JTing86/Medistation_FYDP2022/PCBs/dispenser/components/footprints/SSOP5/SSOP5_ROM.step

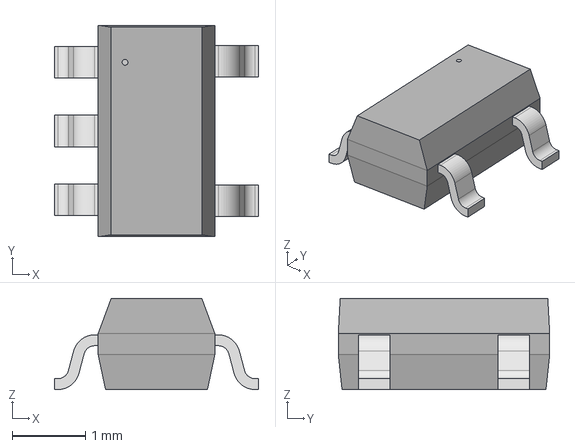
[picture p1: CAD file, 2022-03-11]
PCBs/dispenser/components/footprints/SSOP5/SSOP5_ROM.step
2.79 x 2.90 x 1.25 mm
