JTing86/Medistation_FYDP2022/PCBs/dispenser/components/footprints/10118194-0001LF/10118194-0001LF.step

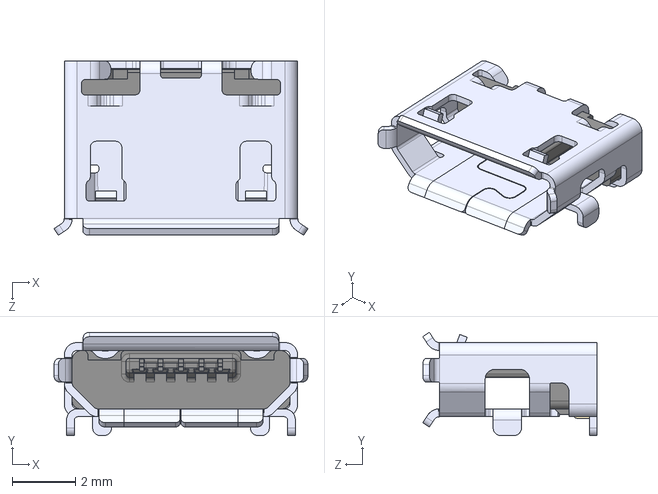
[picture p2: CAD file, 2022-03-11]
PCBs/dispenser/components/footprints/10118194-0001LF/10118194-0001LF.step
8.05 x 3.27 x 5.53 mm
