JTing86/Medistation_FYDP2022/PCBs/dispenser/dispenser.kicad_pcb

## KiCad design PCBs/dispenser/dispenser.kicad_pcb (2022-03-11)

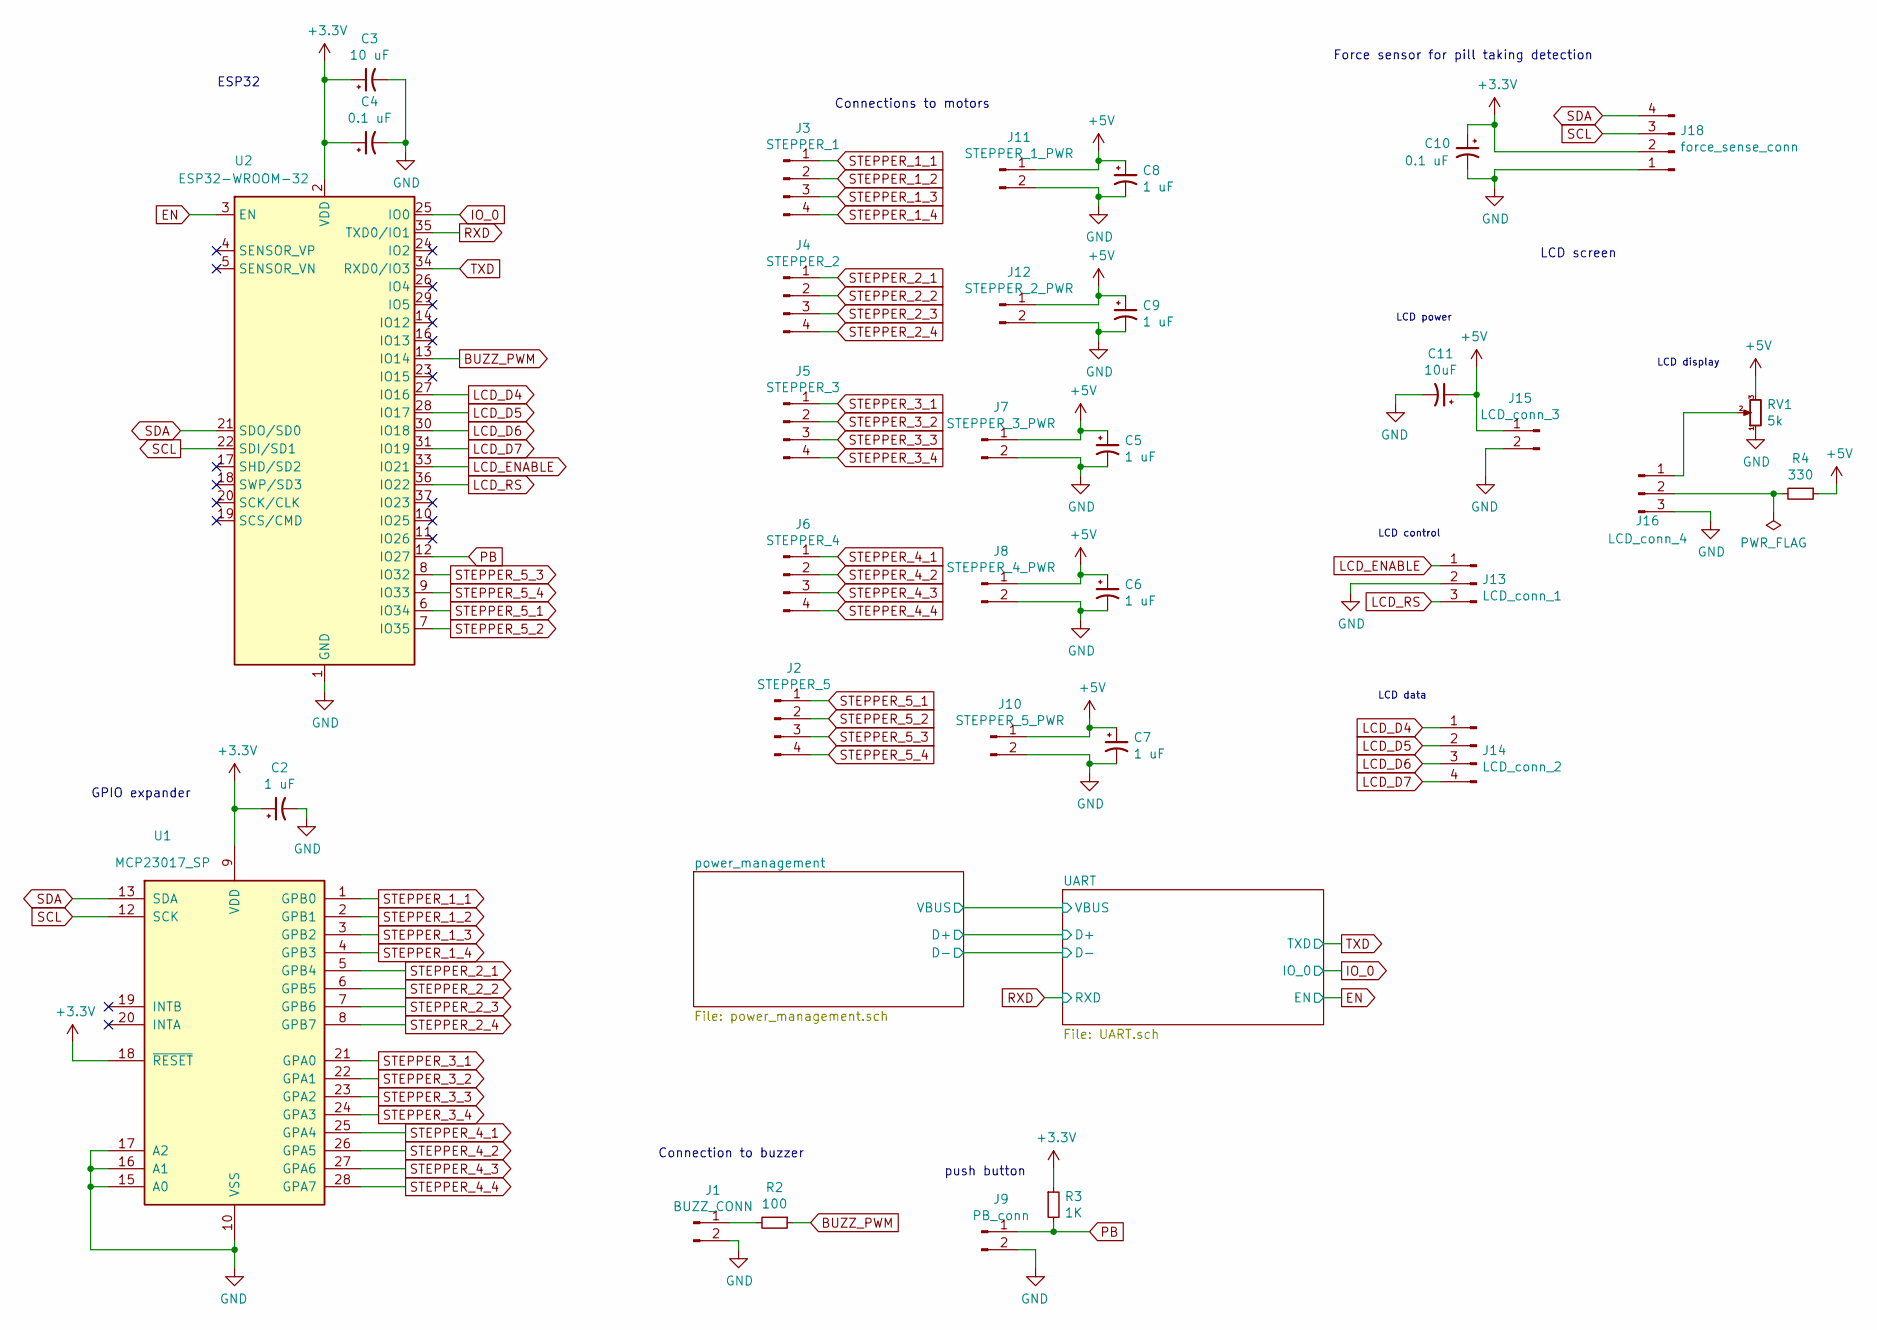
[picture p3: schematic dispenser.sch]

Parts:
C2, C5, C6, C7, C8, C9: 1 uF; C_0603_1608Metric_Pad1.08x0.95mm_HandSolder
C3: 10 uF; C_0603_1608Metric_Pad1.08x0.95mm_HandSolder
C4, C10: 0.1 uF; C_0603_1608Metric_Pad1.08x0.95mm_HandSolder
C11: 10uF; C_0603_1608Metric_Pad1.08x0.95mm_HandSolder
J1: BUZZ_CONN; PinHeader_1x02_P2.54mm_Vertical
J2: STEPPER_5; PinHeader_1x04_P2.54mm_Vertical
J3: STEPPER_1; PinHeader_1x04_P2.54mm_Vertical
J4: STEPPER_2; PinHeader_1x04_P2.54mm_Vertical
J5: STEPPER_3; PinHeader_1x04_P2.54mm_Vertical
J6: STEPPER_4; PinHeader_1x04_P2.54mm_Vertical
J7: STEPPER_3_PWR; B2B-ZRLFSN
J8: STEPPER_4_PWR; B2B-ZRLFSN
J9: PB_conn; PinHeader_1x02_P2.54mm_Vertical
J10: STEPPER_5_PWR; B2B-ZRLFSN
J11: STEPPER_1_PWR; B2B-ZRLFSN
J12: STEPPER_2_PWR; B2B-ZRLFSN
J13: LCD_conn_1; PinHeader_1x03_P2.54mm_Vertical
J14: LCD_conn_2; PinHeader_1x04_P2.54mm_Vertical
J15: LCD_conn_3; PinHeader_1x02_P2.54mm_Vertical
J16: LCD_conn_4; PinHeader_1x03_P2.54mm_Vertical
J18: force_sense_conn; PinHeader_1x04_P2.54mm_Vertical
R2: 100; R_0603_1608Metric_Pad0.98x0.95mm_HandSolder
R3: 1K; R_0603_1608Metric_Pad0.98x0.95mm_HandSolder
R4: 330; R_0603_1608Metric_Pad0.98x0.95mm_HandSolder
RV1: 5k; CT-6EP501
U1: MCP23017_SP; DIP-28_W7.62mm
U2: ESP32-WROOM-32

Connections:
+3V3: C2.1, C3.1, C4.1, C10.1, J18.2, R3.1, U1.9 (VDD), U1.18 (~RESET~), U2.2 (VDD); also elsewhere on the board
+5V: C5.1, C6.1, C7.1, C8.1, C9.1, C11.1, J7.1, J8.1, J10.1, J11.1, J12.1, J15.1, R4.1, RV1.3; also elsewhere on the board
BUZZ_PWM: R2.1, U2.13 (IO14)
EN: U2.3 (EN); also elsewhere on the board
GND: C2.2, C3.2, C4.2, C5.2, C6.2, C7.2, C8.2, C9.2, C10.2, C11.2, J1.2, J7.2, J8.2, J9.2, J10.2, J11.2, J12.2, J13.2, J15.2, J16.3, J18.1, RV1.1, U1.10 (VSS), U1.15 (A0), U1.16 (A1), U1.17 (A2), U2.1 (GND), U2.15 (GND), U2.38 (GND), U2.39 (GND); also elsewhere on the board
IO_0: U2.25 (IO0); also elsewhere on the board
LCD_D4: J14.1, U2.27 (IO16)
LCD_D5: J14.2, U2.28 (IO17)
LCD_D6: J14.3, U2.30 (IO18)
LCD_D7: J14.4, U2.31 (IO19)
LCD_ENABLE: J13.1, U2.33 (IO21)
LCD_RS: J13.3, U2.36 (IO22)
unnamed: J1.1, R2.2
unnamed: J16.1, RV1.2
unnamed: J16.2, R4.2
PB: J9.1, R3.2, U2.12 (IO27)
RXD: U2.35 (TXD0/IO1); also elsewhere on the board
SCL: J18.3, U1.12 (SCK), U2.22 (SDI/SD1)
SDA: J18.4, U1.13 (SDA), U2.21 (SDO/SD0)
STEPPER_1_1: J3.1, U1.1 (GPB0)
STEPPER_1_2: J3.2, U1.2 (GPB1)
STEPPER_1_3: J3.3, U1.3 (GPB2)
STEPPER_1_4: J3.4, U1.4 (GPB3)
STEPPER_2_1: J4.1, U1.5 (GPB4)
STEPPER_2_2: J4.2, U1.6 (GPB5)
STEPPER_2_3: J4.3, U1.7 (GPB6)
STEPPER_2_4: J4.4, U1.8 (GPB7)
STEPPER_3_1: J5.1, U1.21 (GPA0)
STEPPER_3_2: J5.2, U1.22 (GPA1)
STEPPER_3_3: J5.3, U1.23 (GPA2)
STEPPER_3_4: J5.4, U1.24 (GPA3)
STEPPER_4_1: J6.1, U1.25 (GPA4)
STEPPER_4_2: J6.2, U1.26 (GPA5)
STEPPER_4_3: J6.3, U1.27 (GPA6)
STEPPER_4_4: J6.4, U1.28 (GPA7)
STEPPER_5_1: J2.1, U2.6 (IO34)
STEPPER_5_2: J2.2, U2.7 (IO35)
STEPPER_5_3: J2.3, U2.8 (IO32)
STEPPER_5_4: J2.4, U2.9 (IO33)
TXD: U2.34 (RXD0/IO3); also elsewhere on the board

Notes on the sheet:
Force sensor for pill taking detection
push button
LCD screen
Connection to buzzer
LCD power
LCD control
LCD data
LCD display
ESP32
GPIO expander
Connections to motors

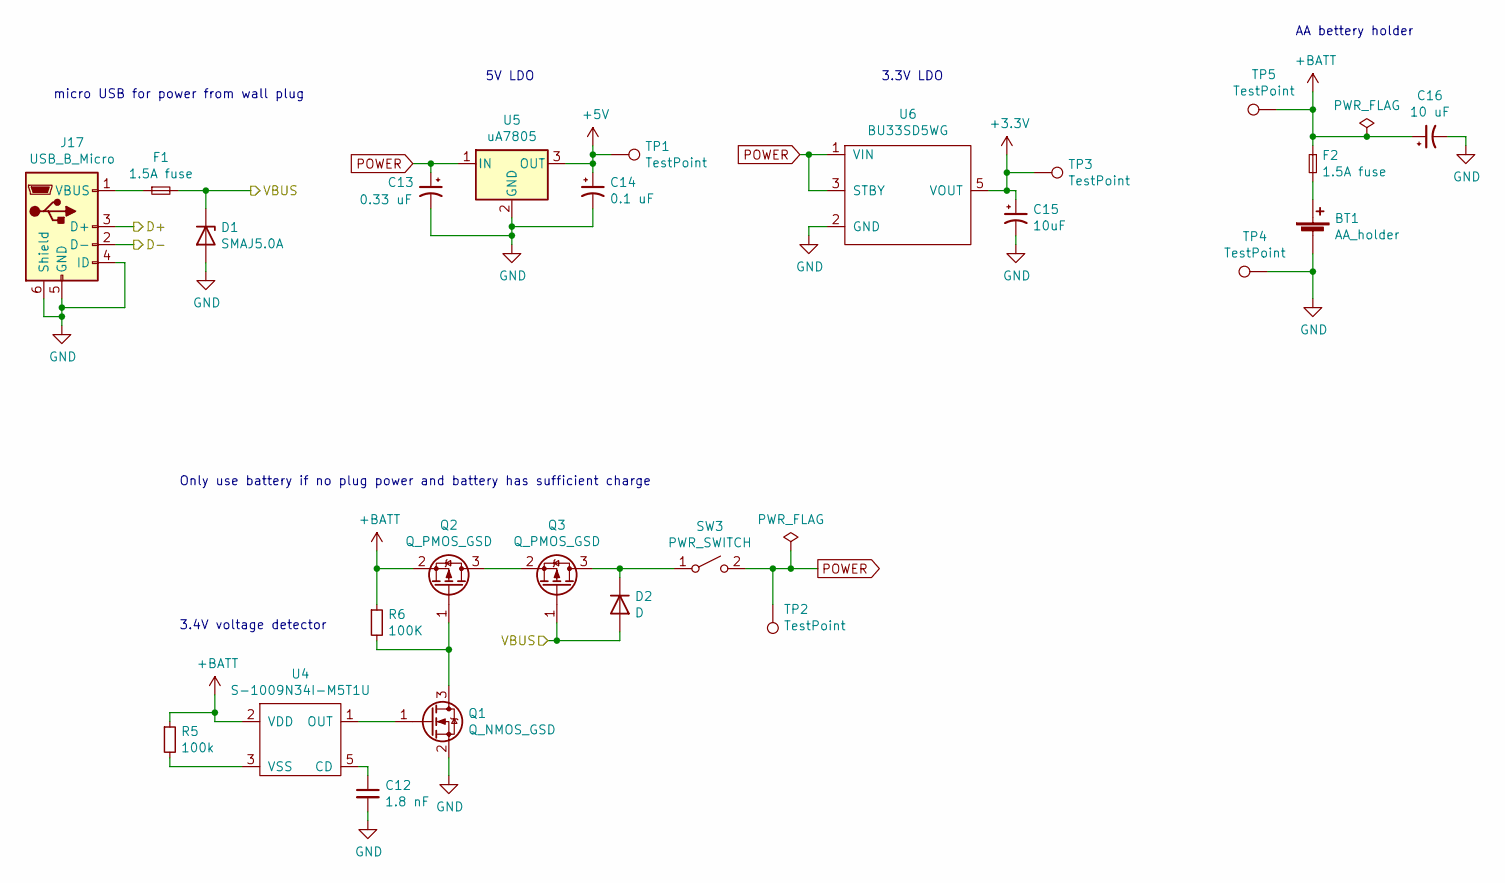
[picture p4: schematic power_management.sch]

Parts:
BT1: AA_holder; battery_holder
C12: 1.8 nF; C_0603_1608Metric_Pad1.08x0.95mm_HandSolder
C13: 0.33 uF; C_0603_1608Metric_Pad1.08x0.95mm_HandSolder
C14: 0.1 uF; C_0603_1608Metric_Pad1.08x0.95mm_HandSolder
C15: 10uF; C_0603_1608Metric_Pad1.08x0.95mm_HandSolder
C16: 10 uF; C_0603_1608Metric_Pad1.08x0.95mm_HandSolder
D1: SMAJ5.0A
D2: D; D_DO-35_SOD27_P7.62mm_Horizontal
F1, F2: 1.5A fuse; Fuse_0603_1608Metric_Pad1.05x0.95mm_HandSolder
J17: USB_B_Micro; AMPHENOL_10118194-0001LF
Q1: Q_NMOS_GSD; SOT-23
Q2, Q3: Q_PMOS_GSD; SOT-23
R5: 100k; R_0603_1608Metric_Pad0.98x0.95mm_HandSolder
R6: 100K; R_0603_1608Metric_Pad0.98x0.95mm_HandSolder
SW3: PWR_SWITCH; M2011S2A1W01
TP1, TP2, TP3, TP4, TP5: TestPoint; TestPoint_Plated_Hole_D2.0mm
U4: S-1009N34I-M5T1U; SOT-23-5_HandSoldering
U5: uA7805; TO-263-3_TabPin2
U6: BU33SD5WG; BU33SD5WG-TR

Connections:
+3V3: C15.1, TP3.1, U6.5 (VOUT); also elsewhere on the board
+5V: C14.1, TP1.1, U5.3 (OUT); also elsewhere on the board
+BATT: C16.1, F2.1, Q2.2 (S), R5.1, R6.1, TP5.1, U4.2 (VDD)
/UART/D+: J17.3 (D+); also elsewhere on the board
/UART/D-: J17.2 (D-); also elsewhere on the board
/UART/VBUS: D1.1 (K), D2.2 (A), F1.2, Q3.1 (G); also elsewhere on the board
GND: BT1.2 (-), C12.2, C13.2, C14.2, C15.2, C16.2, D1.2 (A), J17.4 (ID), J17.5 (GND), J17.6 (Shield), Q1.2 (S), TP4.1, U5.2 (GND), U6.2 (GND); also elsewhere on the board
unnamed: BT1.1 (+), F2.2
unnamed: C12.1, U4.5 (CD)
unnamed: D2.1 (K), Q3.3 (D), SW3.1 (A)
unnamed: F1.1, J17.1 (VBUS)
unnamed: Q1.1 (G), U4.1 (OUT)
unnamed: Q1.3 (D), Q2.1 (G), R6.2
unnamed: Q2.3 (D), Q3.2 (S)
unnamed: R5.2, U4.3 (VSS)
POWER: C13.1, SW3.2 (B), TP2.1, U5.1 (IN), U6.1 (VIN), U6.3 (STBY)

Notes on the sheet:
micro USB for power from wall plug
5V LDO
3.3V LDO
AA bettery holder
Only use battery if no plug power and battery has sufficient charge
3.4V voltage detector

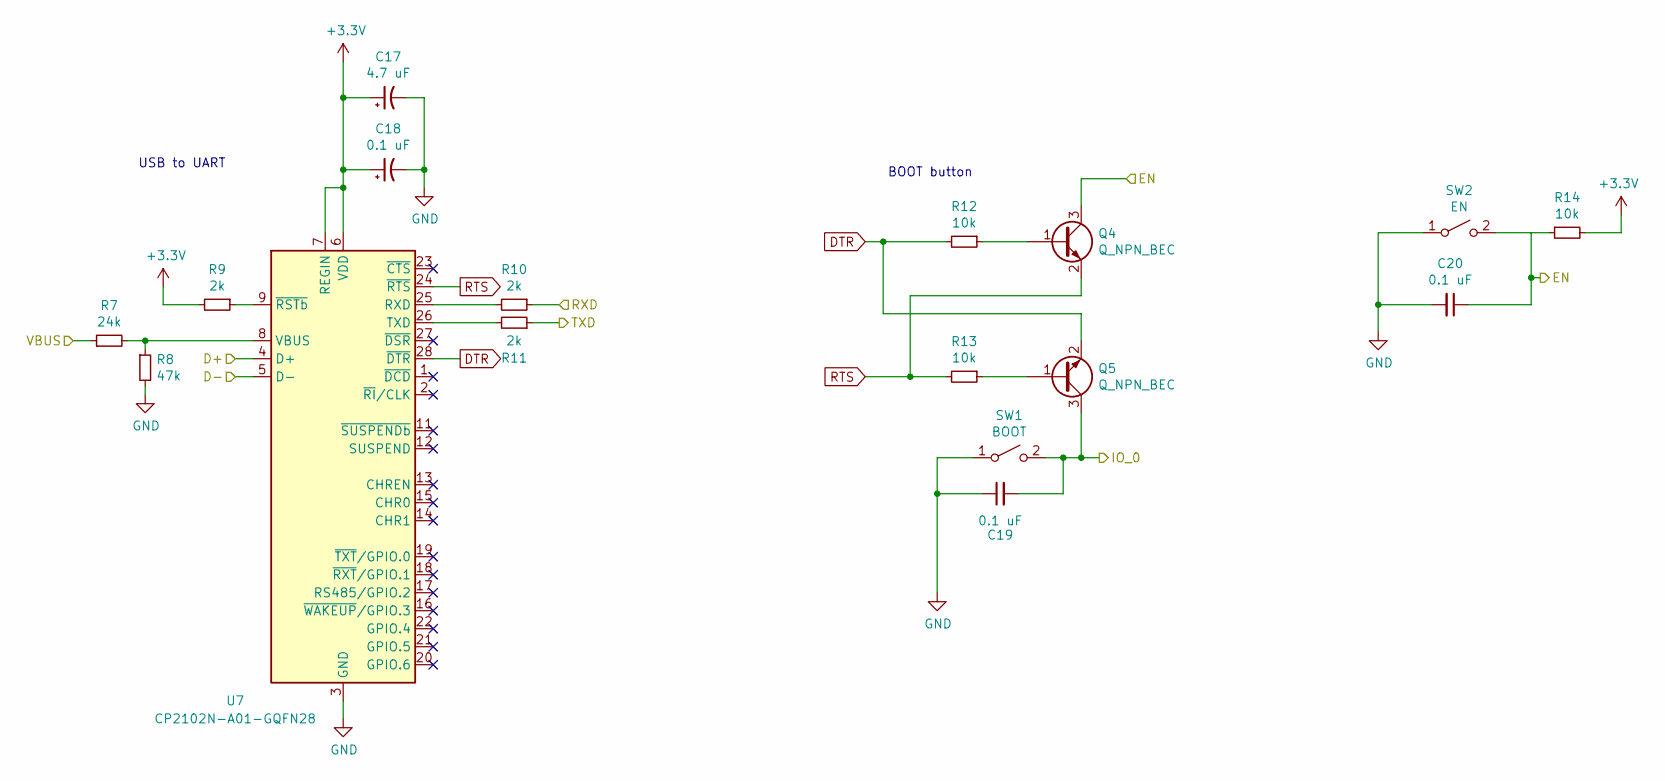
[picture p5: schematic UART.sch]

Parts:
C17: 4.7 uF; C_0603_1608Metric_Pad1.08x0.95mm_HandSolder
C18, C19, C20: 0.1 uF; C_0603_1608Metric_Pad1.08x0.95mm_HandSolder
Q4, Q5: Q_NPN_BEC; SOT-23
R7: 24k; R_0603_1608Metric_Pad0.98x0.95mm_HandSolder
R8: 47k; R_0603_1608Metric_Pad0.98x0.95mm_HandSolder
R9, R10, R11: 2k; R_0603_1608Metric_Pad0.98x0.95mm_HandSolder
R12, R13, R14: 10k; R_0603_1608Metric_Pad0.98x0.95mm_HandSolder
SW1: BOOT; button
SW2: EN; button
U7: CP2102N-A01-GQFN28; QFN-28-1EP_5x5mm_P0.5mm_EP3.35x3.35mm

Connections:
+3V3: C17.1, C18.1, R9.2, R14.2, U7.6 (VDD), U7.7 (REGIN); also elsewhere on the board
/UART/D+: U7.4 (D+); also elsewhere on the board
/UART/D-: U7.5 (D-); also elsewhere on the board
/UART/VBUS: R7.1; also elsewhere on the board
DTR: Q5.2 (E), R12.2, U7.28 (~DTR)
EN: C20.1, Q4.3 (C), R14.1, SW2.2 (B); also elsewhere on the board
GND: C17.2, C18.2, C19.1, C20.2, R8.2, SW1.1 (A), SW2.1 (A), U7.3 (GND), U7.29 (GND); also elsewhere on the board
IO_0: C19.2, Q5.3 (C), SW1.2 (B); also elsewhere on the board
unnamed: Q4.1 (B), R12.1
unnamed: Q5.1 (B), R13.1
unnamed: R7.2, R8.1, U7.8 (VBUS)
unnamed: R9.1, U7.9 (~RSTb)
unnamed: R10.2, U7.25 (RXD)
unnamed: R11.2, U7.26 (TXD)
RTS: Q4.2 (E), R13.2, U7.24 (~RTS)
RXD: R10.1; also elsewhere on the board
TXD: R11.1; also elsewhere on the board

Notes on the sheet:
USB to UART
BOOT button

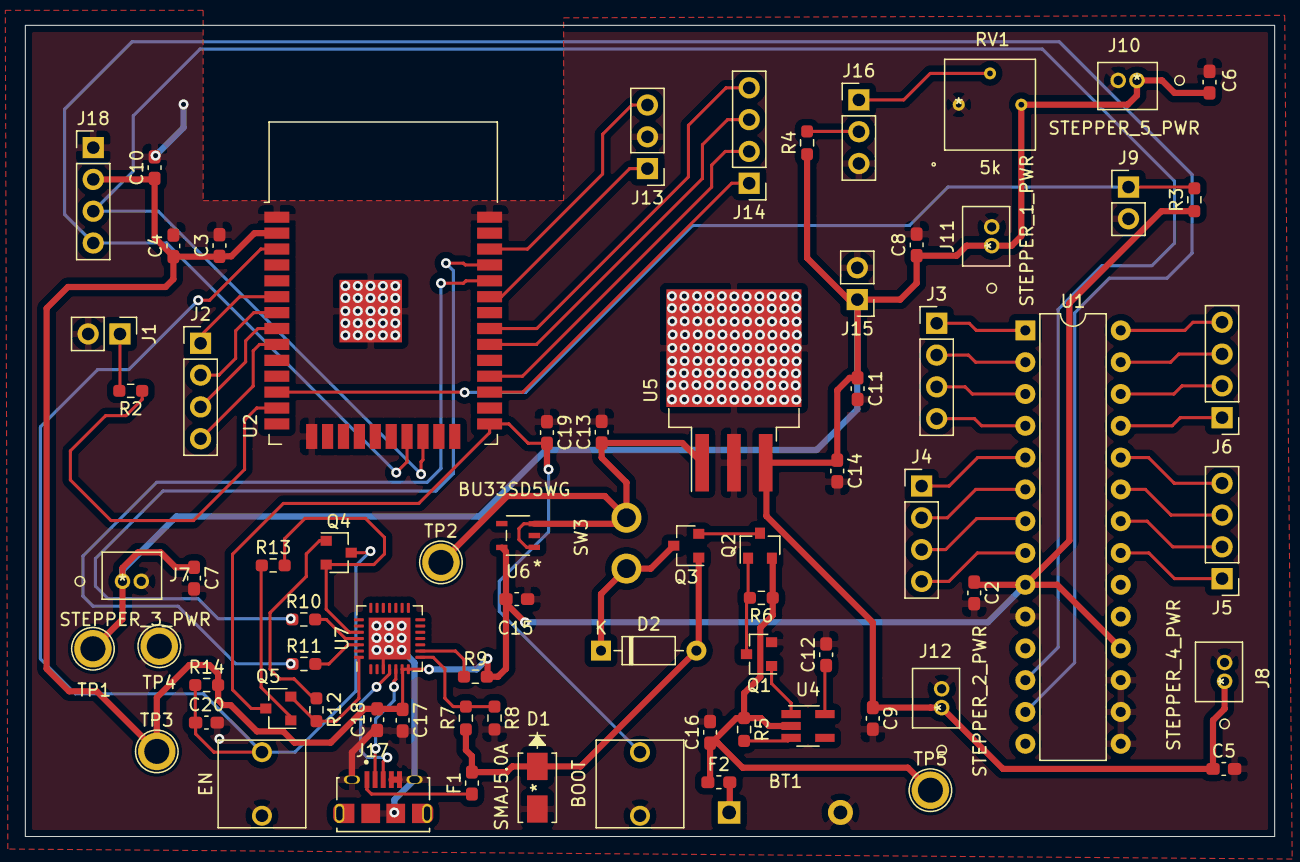
[picture p6: board dispenser.kicad_pcb from above]

Board: 2 copper layers, 99.8 x 64.8 mm, 75 parts (0 on the bottom side), 61 nets.
