JTing86/Medistation_FYDP2022/PCBs/wristband/wristband.kicad_pcb

## KiCad design PCBs/wristband/wristband.kicad_pcb (2022-03-11)

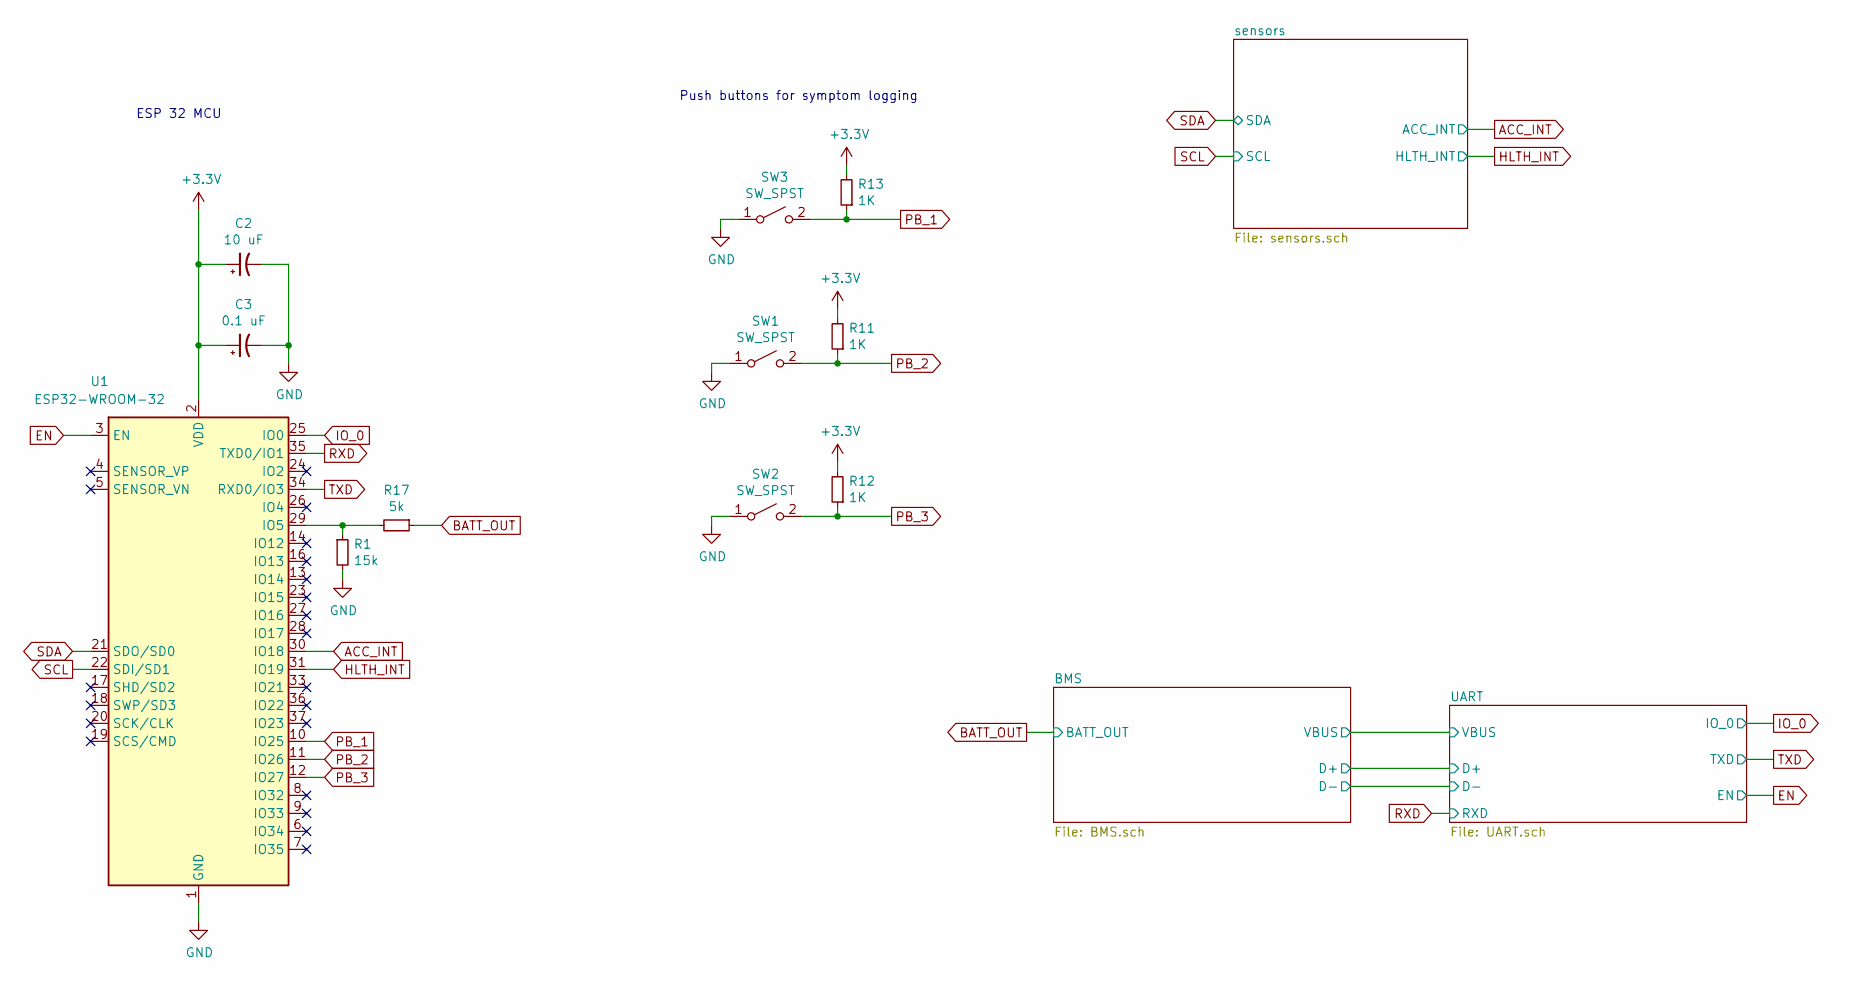
[picture p7: schematic wristband.sch]

Parts:
C2: 10 uF; C_0603_1608Metric_Pad1.08x0.95mm_HandSolder
C3: 0.1 uF; C_0603_1608Metric_Pad1.08x0.95mm_HandSolder
R1: 15k; R_0603_1608Metric_Pad0.98x0.95mm_HandSolder
R11, R12, R13: 1K; R_0603_1608Metric_Pad0.98x0.95mm_HandSolder
R17: 5k; R_0603_1608Metric_Pad0.98x0.95mm_HandSolder
SW1, SW2, SW3: SW_SPST; button
U1: ESP32-WROOM-32

Connections:
+3V3: C2.1, C3.1, R11.2, R12.2, R13.2, U1.2 (VDD); also elsewhere on the board
ACC_INT: U1.30 (IO18); also elsewhere on the board
BATT_OUT: R17.1; also elsewhere on the board
EN: U1.3 (EN); also elsewhere on the board
GND: C2.2, C3.2, R1.2, SW1.1 (A), SW2.1 (A), SW3.1 (A), U1.1 (GND), U1.15 (GND), U1.38 (GND), U1.39 (GND); also elsewhere on the board
HLTH_INT: U1.31 (IO19); also elsewhere on the board
IO_0: U1.25 (IO0); also elsewhere on the board
unnamed: R1.1, R17.2, U1.29 (IO5)
PB_1: R13.1, SW3.2 (B), U1.10 (IO25)
PB_2: R11.1, SW1.2 (B), U1.11 (IO26)
PB_3: R12.1, SW2.2 (B), U1.12 (IO27)
RXD: U1.35 (TXD0/IO1); also elsewhere on the board
SCL: U1.22 (SDI/SD1); also elsewhere on the board
SDA: U1.21 (SDO/SD0); also elsewhere on the board
TXD: U1.34 (RXD0/IO3); also elsewhere on the board

Notes on the sheet:
Push buttons for symptom logging
ESP 32 MCU

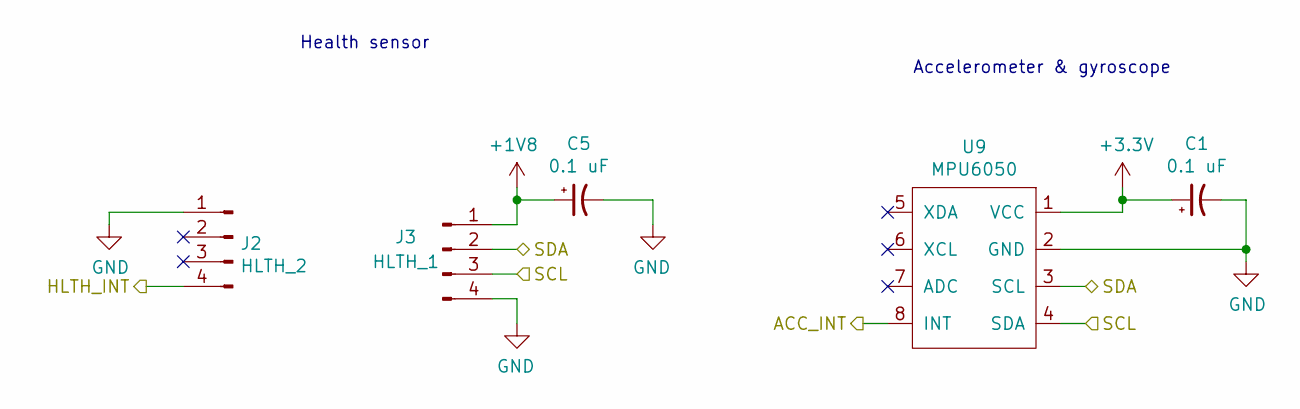
[picture p8: schematic sensors.sch]

Parts:
C1, C5: 0.1 uF; C_0603_1608Metric_Pad1.08x0.95mm_HandSolder
J2: HLTH_2; PinHeader_1x04_P2.54mm_Vertical
J3: HLTH_1; PinHeader_1x04_P2.54mm_Vertical
U9: MPU6050

Connections:
+1V8: C5.1, J3.1; also elsewhere on the board
+3V3: C1.1, U9.1 (VCC); also elsewhere on the board
ACC_INT: U9.8 (INT); also elsewhere on the board
GND: C1.2, C5.2, J2.1, J3.4, U9.2 (GND); also elsewhere on the board
HLTH_INT: J2.4; also elsewhere on the board
SCL: J3.3, U9.4 (SDA); also elsewhere on the board
SDA: J3.2, U9.3 (SCL); also elsewhere on the board

Notes on the sheet:
Health sensor
Accelerometer & gyroscope

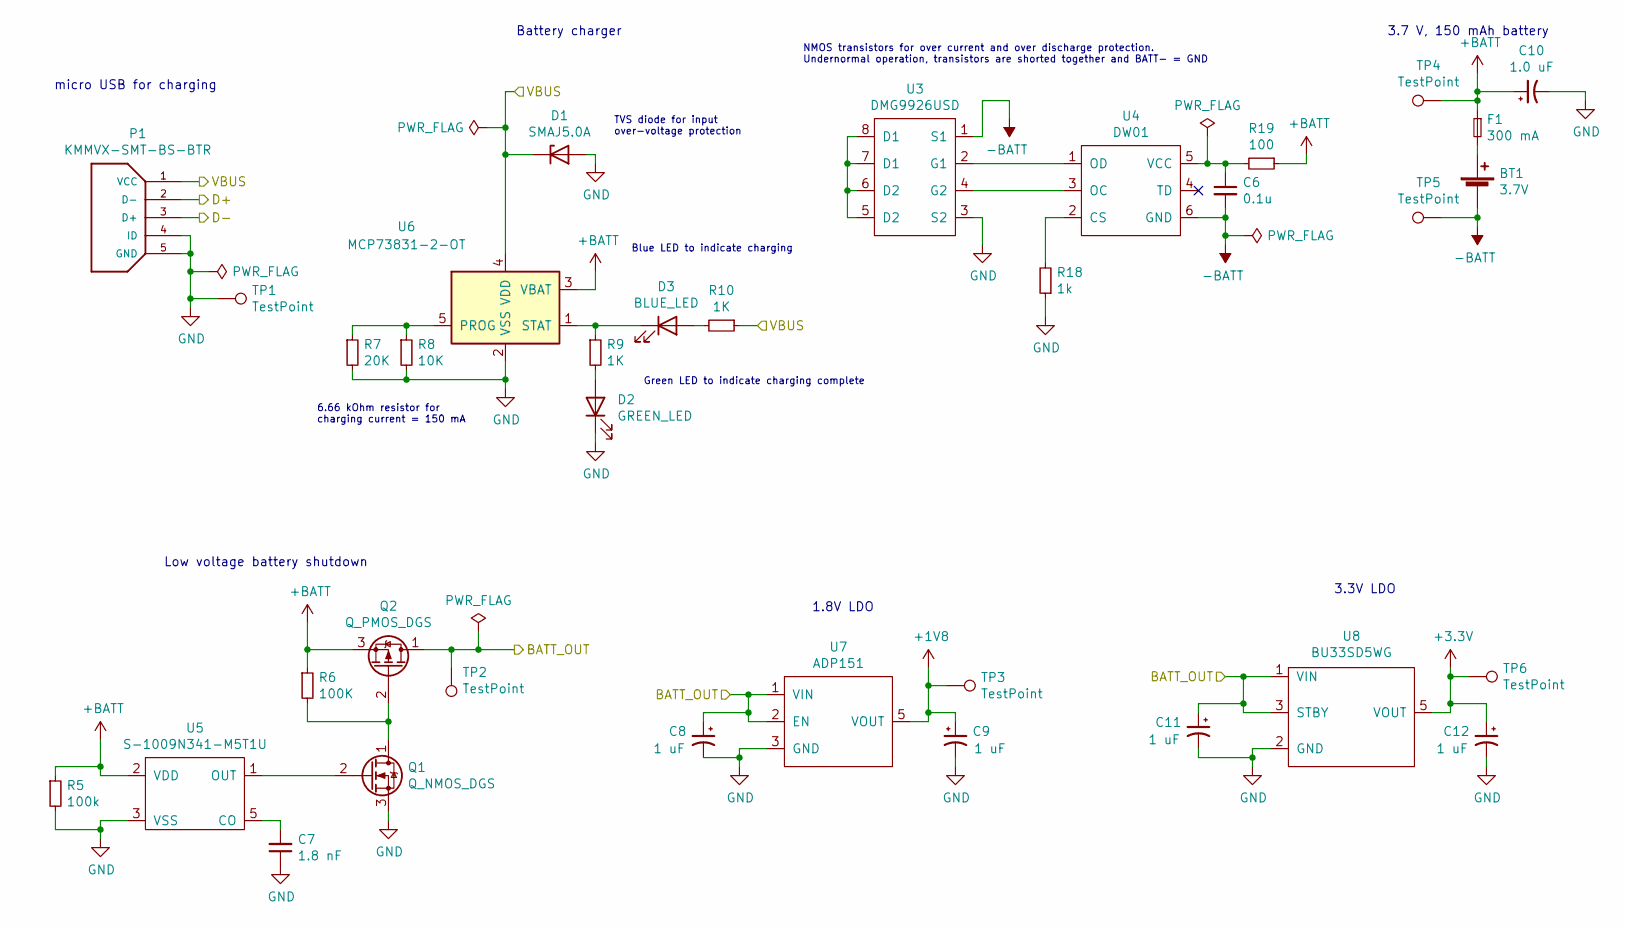
[picture p9: schematic BMS.sch]

Parts:
BT1: 3.7V; battery
C6: 0.1u; C_0603_1608Metric_Pad1.08x0.95mm_HandSolder
C7: 1.8 nF; C_0603_1608Metric_Pad1.08x0.95mm_HandSolder
C8, C9, C11, C12: 1 uF; C_0603_1608Metric_Pad1.08x0.95mm_HandSolder
C10: 1.0 uF; C_0603_1608Metric_Pad1.08x0.95mm_HandSolder
D1: SMAJ5.0A
D2: GREEN_LED; LED_0603_1608Metric_Pad1.05x0.95mm_HandSolder
D3: BLUE_LED; LED_0603_1608Metric_Pad1.05x0.95mm_HandSolder
F1: 300 mA; Fuse_0603_1608Metric_Pad1.05x0.95mm_HandSolder
P1: KMMVX-SMT-BS-BTR; KYCON_KMMVX-SMT-BS-BTR
Q1: Q_NMOS_DGS; SOT-23
Q2: Q_PMOS_DGS; SOT-23
R5: 100k; R_0603_1608Metric_Pad0.98x0.95mm_HandSolder
R6: 100K; R_0603_1608Metric_Pad0.98x0.95mm_HandSolder
R7: 20K; R_0603_1608Metric_Pad0.98x0.95mm_HandSolder
R8: 10K; R_0603_1608Metric_Pad0.98x0.95mm_HandSolder
R9, R10: 1K; R_0603_1608Metric_Pad0.98x0.95mm_HandSolder
R18: 1k; R_0603_1608Metric_Pad0.98x0.95mm_HandSolder
R19: 100; R_0603_1608Metric_Pad0.98x0.95mm_HandSolder
TP1, TP2, TP3, TP4, TP5, TP6: TestPoint; TestPoint_Loop_D2.50mm_Drill1.0mm_LowProfile
U3: DMG9926USD; SOP-8_3.9x4.9mm_P1.27mm
U4: DW01; SOT-23-6_Handsoldering
U5: S-1009N341-M5T1U; SOT-23-5_HandSoldering
U6: MCP73831-2-OT; SOT-23-5_HandSoldering
U7: ADP151; SOT-23-5_HandSoldering
U8: BU33SD5WG; BU33SD5WG-TR

Connections:
+1V8: C9.1, TP3.1, U7.5 (VOUT); also elsewhere on the board
+3V3: C12.1, TP6.1, U8.5 (VOUT); also elsewhere on the board
+BATT: C10.1, F1.1, Q2.3 (S), R5.1, R6.1, R19.1, TP4.1, U5.2 (VDD), U6.3 (VBAT)
-BATT: BT1.2 (-), C6.2, TP5.1, U3.1 (S1), U4.6 (GND)
/BMS/D+: P1.2 (D-); also elsewhere on the board
/BMS/D-: P1.3 (D+); also elsewhere on the board
/BMS/VBUS: D1.1 (K), P1.1 (VCC), R10.1, U6.4 (VDD); also elsewhere on the board
BATT_OUT: C8.1, C11.1, Q2.1 (D), TP2.1, U7.1 (VIN), U7.2 (EN), U8.1 (VIN), U8.3 (STBY); also elsewhere on the board
GND: C7.1, C8.2, C9.2, C10.2, C11.2, C12.2, D1.2 (A), D2.1 (K), P1.4 (ID), P1.5 (GND), Q1.3 (S), R5.2, R7.2, R8.2, R18.1, TP1.1, U3.3 (S2), U5.3 (VSS), U6.2 (VSS), U7.3 (GND), U8.2 (GND); also elsewhere on the board
unnamed: BT1.1 (+), F1.2
unnamed: C6.1, R19.2, U4.5 (VCC)
unnamed: C7.2, U5.5 (CO)
unnamed: D2.2 (A), R9.2
unnamed: D3.1 (K), R9.1, U6.1 (STAT)
unnamed: D3.2 (A), R10.2
unnamed: Q1.1 (D), Q2.2 (G), R6.2
unnamed: Q1.2 (G), U5.1 (OUT)
unnamed: R7.1, R8.1, U6.5 (PROG)
unnamed: R18.2, U4.2 (CS)
unnamed: U3.2 (G1), U4.1 (OD)
unnamed: U3.4 (G2), U4.3 (OC)
unnamed: U3.5 (D2), U3.6 (D2), U3.7 (D1), U3.8 (D1)

Notes on the sheet:
Blue LED to indicate charging
Green LED to indicate charging complete
6.66 kOhm resistor for charging current = 150 mA
TVS diode for input over-voltage protection
micro USB for charging
3.7 V, 150 mAh battery
Battery charger
1.8V LDO
3.3V LDO
Low voltage battery shutdown
NMOS transistors for over current and over discharge protection. Undernormal operation, transistors are shorted together and BATT- = GND

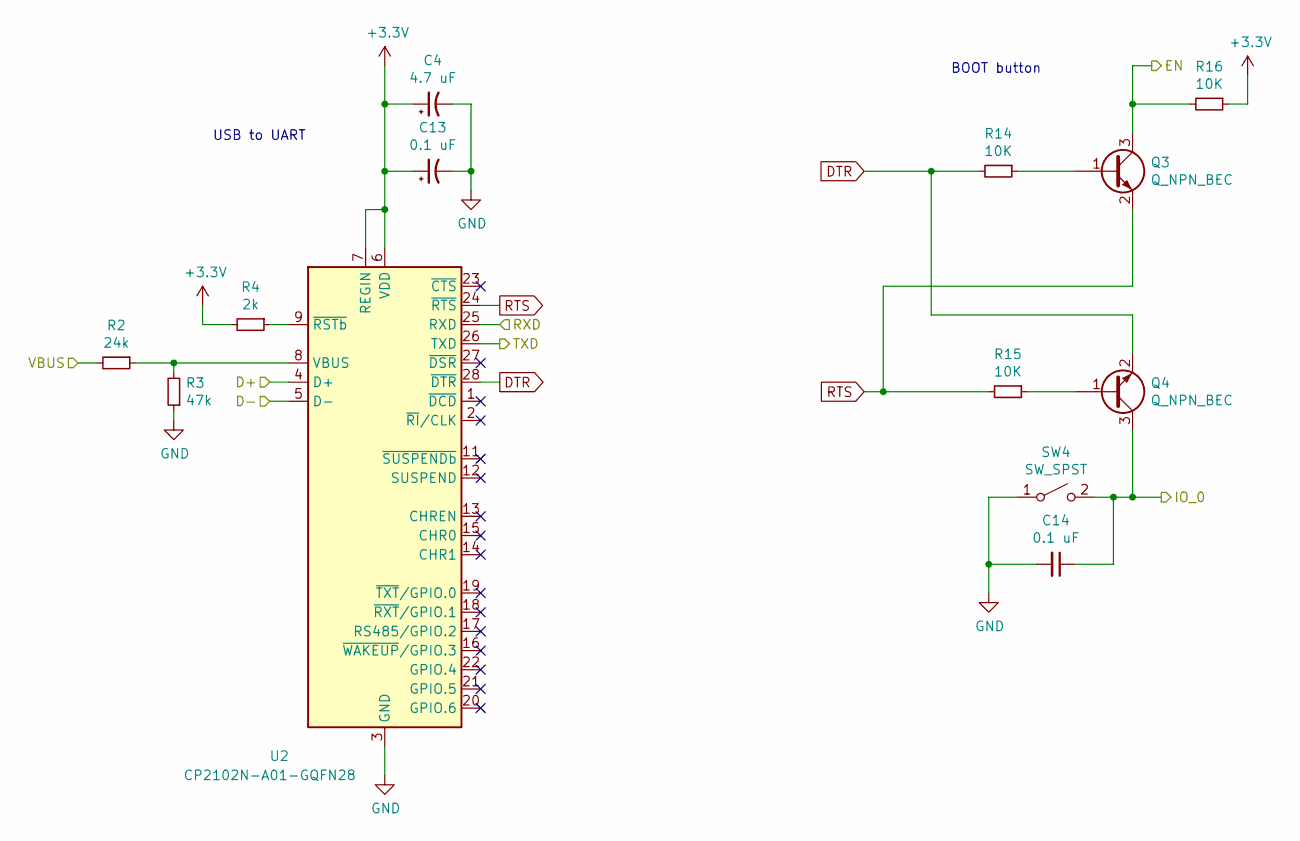
[picture p10: schematic UART.sch]

Parts:
C4: 4.7 uF; C_0603_1608Metric_Pad1.08x0.95mm_HandSolder
C13, C14: 0.1 uF; C_0603_1608Metric_Pad1.08x0.95mm_HandSolder
Q3, Q4: Q_NPN_BEC; SOT-23
R2: 24k; R_0603_1608Metric_Pad0.98x0.95mm_HandSolder
R3: 47k; R_0603_1608Metric_Pad0.98x0.95mm_HandSolder
R4: 2k; R_0603_1608Metric_Pad0.98x0.95mm_HandSolder
R14, R15, R16: 10K; R_0603_1608Metric_Pad0.98x0.95mm_HandSolder
SW4: SW_SPST; button
U2: CP2102N-A01-GQFN28; QFN-28-1EP_5x5mm_P0.5mm_EP3.35x3.35mm

Connections:
+3V3: C4.1, C13.1, R4.2, R16.1, U2.6 (VDD), U2.7 (REGIN); also elsewhere on the board
/BMS/D+: U2.4 (D+); also elsewhere on the board
/BMS/D-: U2.5 (D-); also elsewhere on the board
/BMS/VBUS: R2.2; also elsewhere on the board
DTR: Q4.2 (E), R14.2, U2.28 (~DTR)
EN: Q3.3 (C), R16.2; also elsewhere on the board
GND: C4.2, C13.2, C14.2, R3.1, SW4.1 (A), U2.3 (GND), U2.29 (GND); also elsewhere on the board
IO_0: C14.1, Q4.3 (C), SW4.2 (B); also elsewhere on the board
unnamed: Q3.1 (B), R14.1
unnamed: Q4.1 (B), R15.1
unnamed: R2.1, R3.2, U2.8 (VBUS)
unnamed: R4.1, U2.9 (~RSTb)
RTS: Q3.2 (E), R15.2, U2.24 (~RTS)
RXD: U2.25 (RXD); also elsewhere on the board
TXD: U2.26 (TXD); also elsewhere on the board

Notes on the sheet:
USB to UART
BOOT button

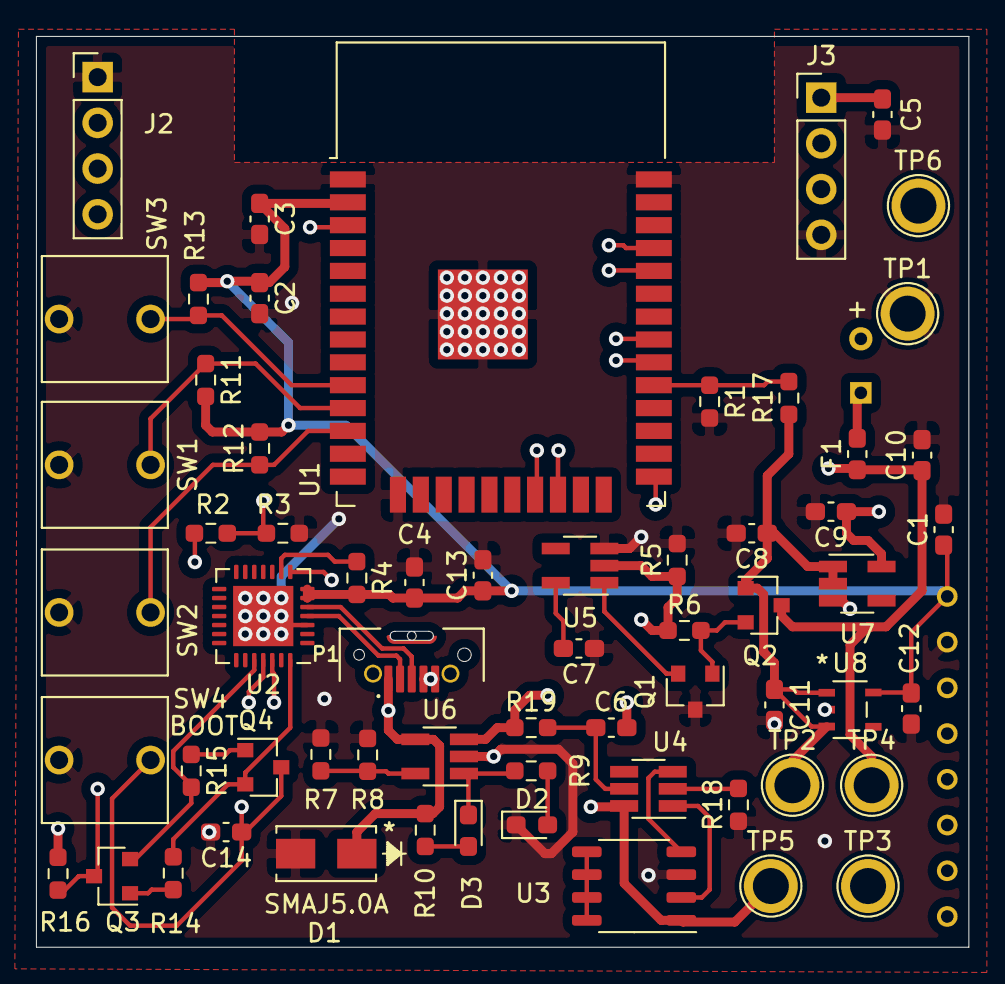
[picture p11: board wristband.kicad_pcb from above]

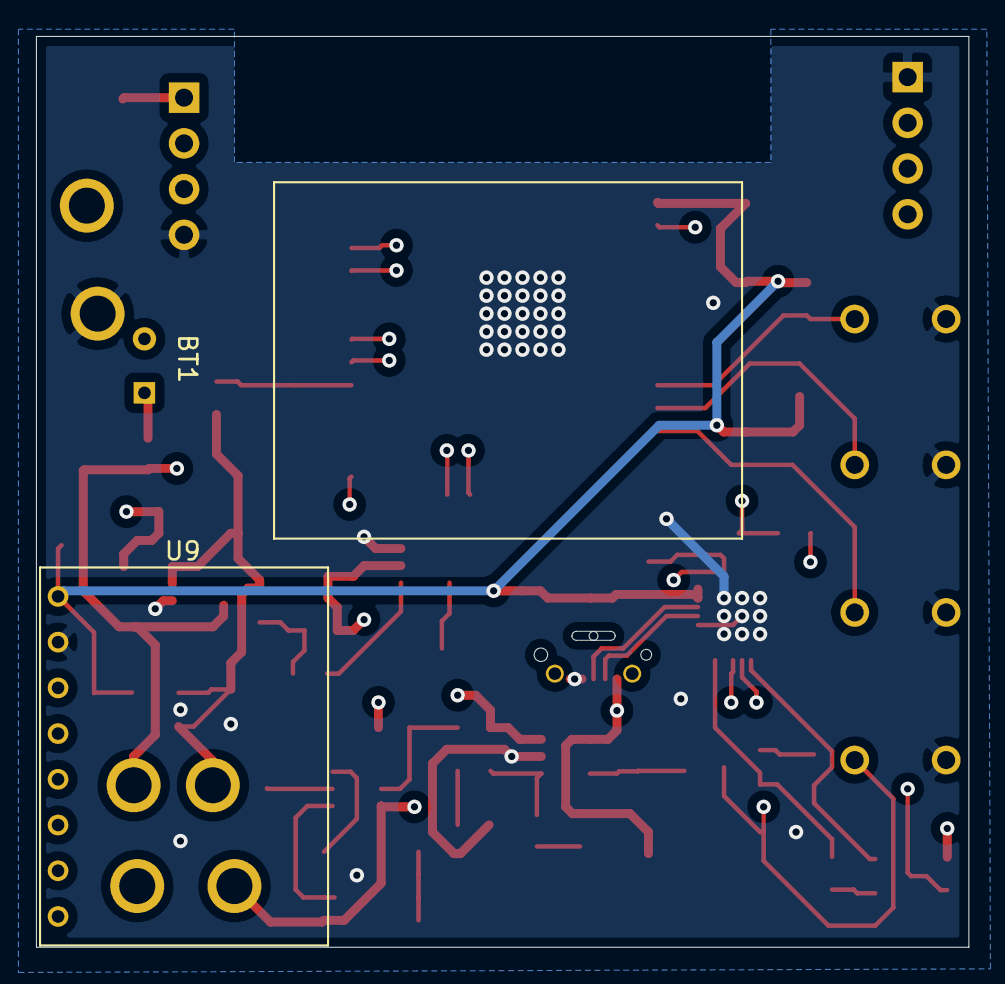
[picture p12: board wristband.kicad_pcb from below]

Board: 4 copper layers, 51.8 x 50.6 mm, 64 parts (2 on the bottom side), 40 nets.
