JTing86/Medistation_FYDP2022/(commit log)

2021-05-28 Added navigation buttons at bottom of screen
2021-06-15 Added Button
2021-06-15 Added Button to add symptom to database
2021-10-14 profile fragment completed with one bug fixed
    [ProfileFragment.java]
2021-10-19 figured out bug regarding calibration section
    [dispenserSettingFragment.java]
2021-11-02 just going through TODO list and fixing up code
    [ProfileFragment.java, dispenserSettingFragment.java]
2021-12-21 need to store current code to debug, navigation bar issue
    [MedicationFragment.java, ProfileFragment.java, dispenserSettingFragment.java, wristbandSettingFragment.java]
2021-12-24 modified ProfileFragment and DeviceFragment based on new MQTT and db structure
2021-12-25 fixed up ProfileFragment, wristbandsettingFragment and dispenserSettingsFragment
    [ProfileFragment.java]
2021-12-25 commit before fixing bug regarding saving pill schedule to DB
    [MedicationFragment.java, ProfileFragment.java, wristbandSettingFragment.java]
2021-12-25 fixed schedule being saved to database bug
    [MedicationFragment.java]
2021-12-29 added health and device status to the HomeFragment
2022-01-15 home_fragment completed but did not check for bugs
    [HomeFragment.java, MedicationFragment.java]
2022-02-26 minor fixes to graph function
    [ProfileFragment.java]
2022-02-28 after integration, need few more fixes
    [HomeFragment.java, MedicationFragment.java, ProfileFragment.java]
2022-03-01 added motor stuff, changed I2c, got rid of pushing incomplete data
2022-03-04 added PCBs
    [10118194-0001LF.step, BMS.sch, SSOP5_ROM.step, UART.sch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]
2022-03-08 need to add button to home fragment (work in progress)
2022-03-09 working needs calibration
